perryPyn/TensegrityRobot/temp/Bottom.stl

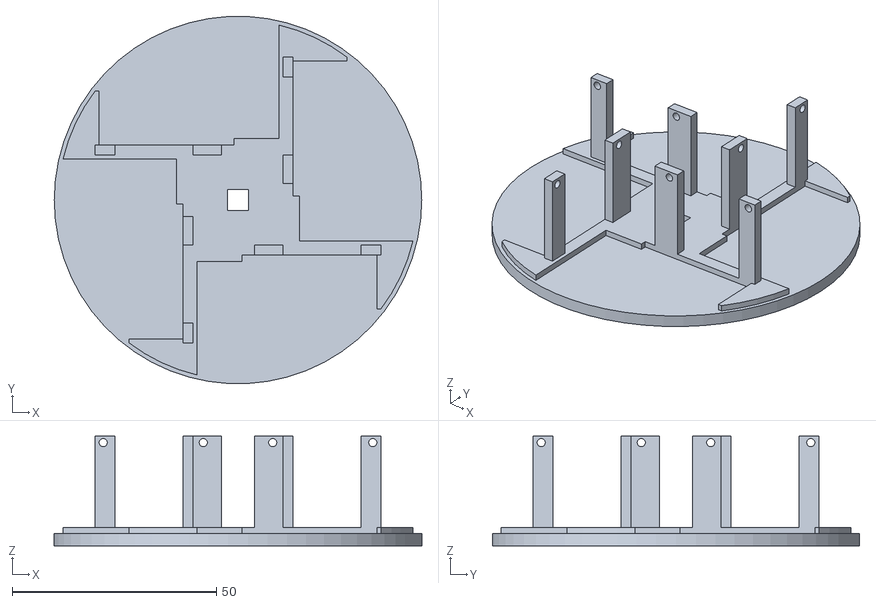
[picture p3: CAD file, 2026-07-07]
temp/Bottom.stl
90.0 x 89.9 x 26.9
