perryPyn/TensegrityRobot/temp/Top.stl

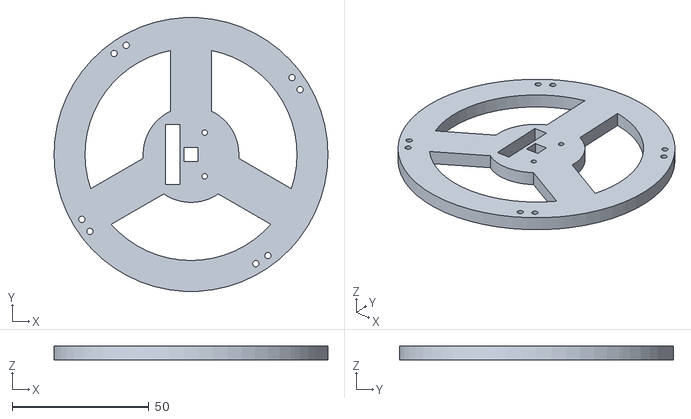
[picture p4: CAD file, 2026-07-07]
temp/Top.stl
100.0 x 99.9 x 5.00
