perryPyn/TensegrityRobot/temp/Barrel.stl

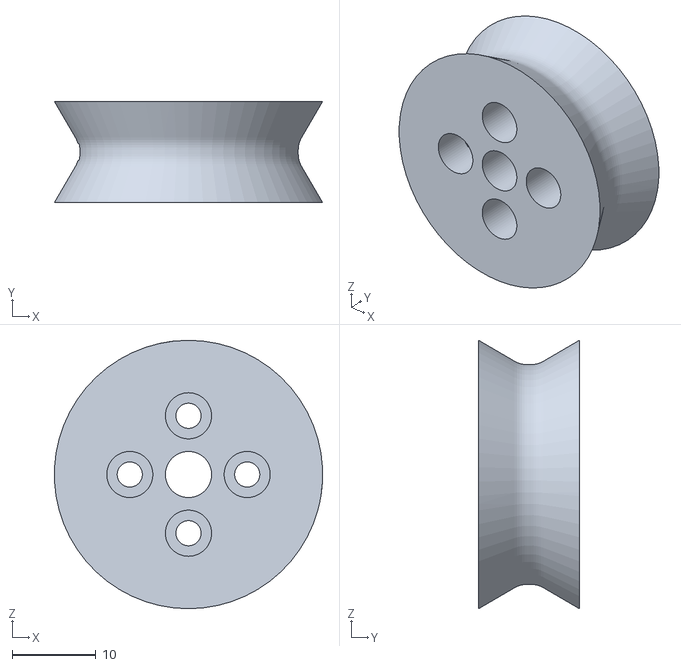
[picture p5: CAD file, 2026-07-07]
temp/Barrel.stl
32.0 x 12.0 x 32.0
