perryPyn/TensegrityRobot/temp/Crochet.stl

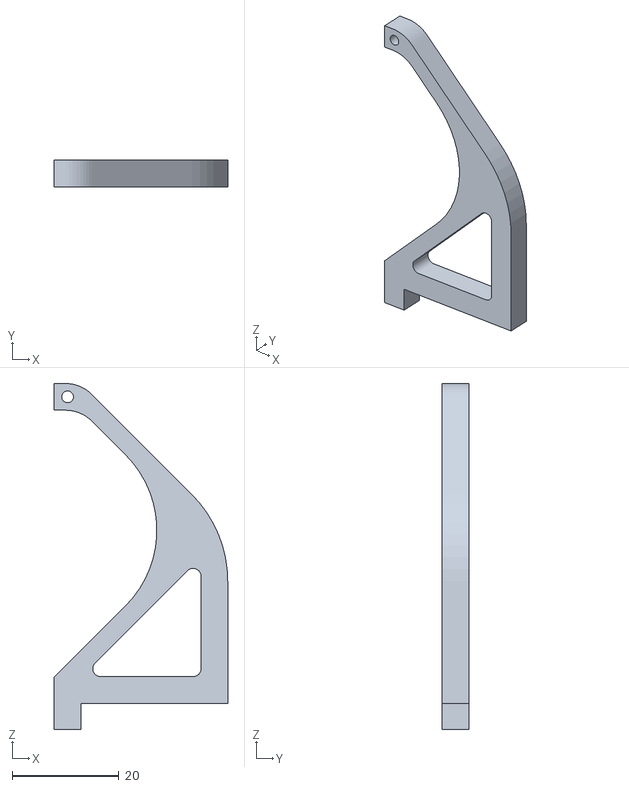
[picture p6: CAD file, 2026-07-07]
temp/Crochet.stl
32.5 x 5.00 x 64.8
