perryPyn/TensegrityRobot/(commit log)

2026-06-11 added stl files
    [Ring.stl, Top_cover.stl, Vertical_support.stl]
2026-06-12 added basic code to move and change servo's id
2026-06-12 Add basic documentation for servo function
2026-06-12 added control for multiple servo and the ability to retrieve infos from them
2026-06-12 added possibility to read infos of multiple servo
2026-06-15 full control via consol, missing multi turn
    [console.cpp, console.h, servo.cpp, servo.h, utils.cpp]
2026-06-17 CAD de la tige
    [Ring.SLDPRT, Tige.step]
2026-06-17 created new folder
    [Tige.step, couvercle_coude.step, socle_bas.step]
2026-06-17 fist iteration of top, missing rotation
    [Top.step, couvercle_coude.step]
2026-06-17 need bool, parts not merged
    [Top.step]
2026-06-17 top part finished
    [Top.step]
2026-06-17 added stl file for top part
    [Ring.SLDPRT, Ring.stl, Top.stl, Top_cover.stl, Vertical_support.stl]
2026-06-18 Ajout du fichier stl de la tige
    [Tige.stl]
2026-06-18 update Top
    [Top.step, Top.stl]
2026-06-18 Nouvelle tige plus courte
    [Tige.step]
2026-06-19 added manual calibration at the launch of the program. added multi-turn configuration via max angle
2026-06-22 corrected initServo, added readLoad
    [console.cpp, console.h, main.cpp, servo.cpp, servo.h, utils.cpp, utils.h]
2026-06-22 Changement de la tige, du socle du haut et du bas pour une structure plus petite et plus stable
    [CrochetCentrale.step, SocleBas.step, SupportServo.step, Tige.step, Top.step, socle_bas.step]
2026-06-22 latest stable driver version
2026-06-26 added multilingual readme for driver
2026-06-26 final commit before release
    [CrochetCentrale.stl, SocleBas.stl, SupportServo.stl, Tige.stl, Top.stl]
2026-07-02 configured new servos
2026-07-03 Code de l'imu pour récupérer l'accélération et l'inclinaison
2026-07-06 +pid +imu
    added pid with dummy values and full imu inegration, missing pid's
    values tuning
    [console.cpp, console.h, imu.cpp, main.cpp, pid.cpp, pid.h]
2026-07-06 added new STLs
    [Barrel.stl, Bottom.stl, Crochet.stl, CrochetCentrale.step, CrochetCentrale.stl, SocleBas.step, SocleBas.stl, SupportServo.step]
2026-07-07 tuned PID
    fully working robot with PID corrector !!
    [main.cpp, servo.cpp]
